davidmctavish/G6_FPGA_Billiards/src/Hardware/project_1/project_1.runs/impl_1/.init_design.begin.rst

<?xml version="1.0"?>
<ProcessHandle Version="1" Minor="0">
    <Process Command=".planAhead." Owner="David" Host="LATITUDE-E5530" Pid="6472">
    </Process>
</ProcessHandle>
