davidmctavish/G6_FPGA_Billiards/src/Hardware/project_1/project_1.runs/impl_1/.vivado.begin.rst

<?xml version="1.0"?>
<ProcessHandle Version="1" Minor="0">
    <Process Command="vivado.bat" Owner="David" Host="LATITUDE-E5530" Pid="6776">
    </Process>
</ProcessHandle>
<?xml version="1.0"?>
<ProcessHandle Version="1" Minor="0">
    <Process Command="vivado.bat" Owner="David" Host="LATITUDE-E5530" Pid="6036">
    </Process>
</ProcessHandle>
