davidmctavish/G6_FPGA_Billiards/src/Hardware/PositionLocatorTest_2014_1/vivado_pid5332.png

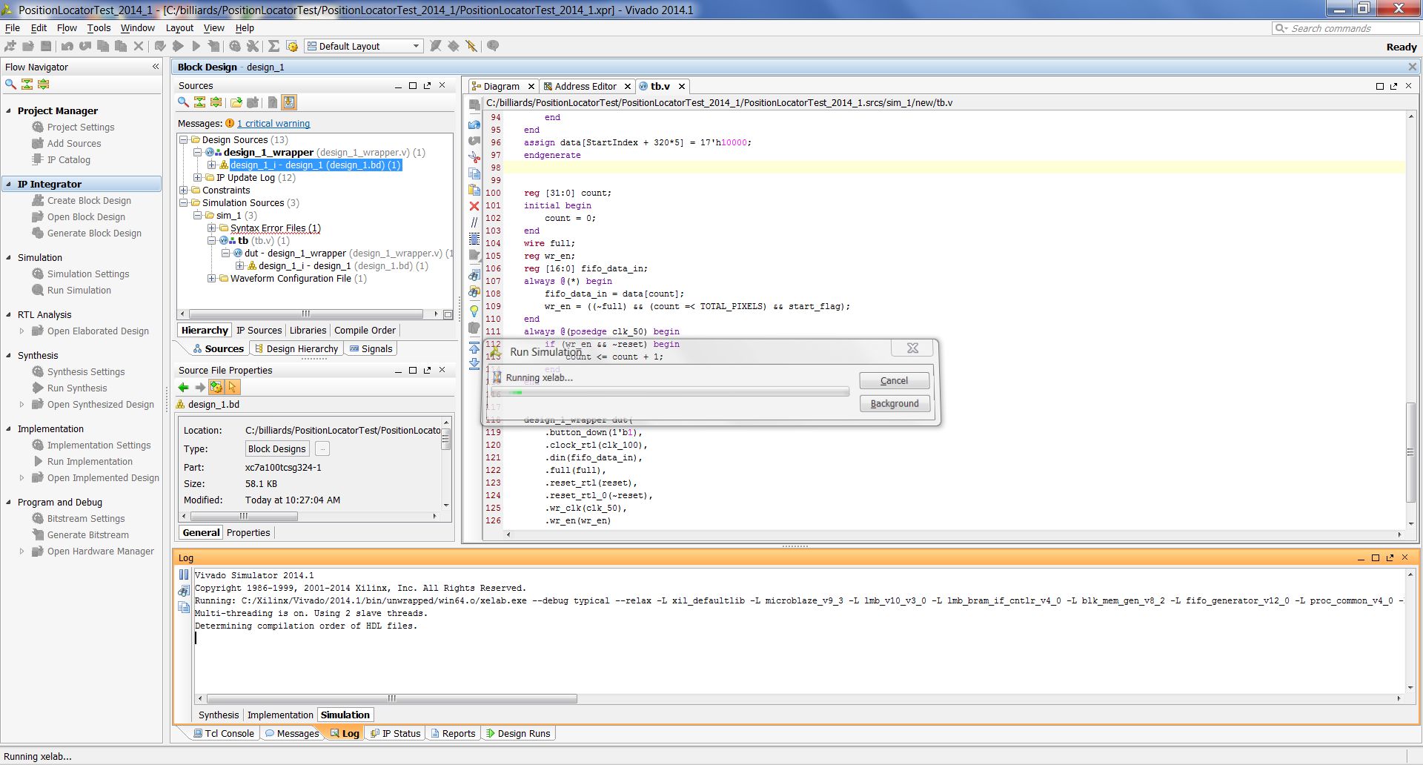
src/Hardware/PositionLocatorTest_2014_1/vivado_pid5332.png
