davidmctavish/G6_FPGA_Billiards/src/Hardware/VivadoIP/ip_repo/poisition_locator_1.0/src/div_gen_0/doc/div_gen_v5_1_changelog.txt

2014.1:
 * Version 5.1 (Rev. 2)
 * C models for Windows are compiled using Microsoft Visual Studio 2012
 * Internal device family name change, no functional changes
 * Netlists created by write_verilog and write_vhdl are IEEE P1735 encrypted, with keys for supported simulators so that netlist simulation can still be done
 * Enable third party synthesis tools to read encrypted netlists (but not source HDL)
 * Support for Virtex Ultrascale devices at Pre-Production Status
 * VCS version H-2013.06-sp1 may cause errors or mismatches between behavioral sim and post- netlists. VCS version I-2014.03-Beta1 or later is recommended.

2013.4:
 * Version 5.1 (Rev. 1)
 * Clock constraint removed from supplied out of context xdc file for cases with no registers
 * ACLKEN and ARESETN disabled ans set to false on GUI when Latency is set to 0
 * Support for Kintex Ultrascale devices at Pre-Production Status

2013.3:
 * Version 5.1
 * Addition of LUT-Mult architecture
 * Addition of configurable latency to Radix 2 architecture
 * Addition of C model
 * Internal standardization in source file delivery, does not change behavior
 * Support for Automotive Artix-7, Automotive Zynq, Defense Grade Artix-7, Defense Grade Zynq and Lower Power Artix-7 devices at Production Status
 * Added support for Cadence IES and Synopsys VCS simulators
 * Added default constraints for out of context flow
 * Added support for IP Integrator
 * Removed C model dependency on stlport (STL Portability) library; C model now uses STL built into the compiler
 * Windows C model DLLs are statically linked to the Windows C run-time (CRT) library, to remove the runtime dependency on MSVCRT90.dll, which can cause problems when using the C model in a Windows compiler other than Visual Studio 2008
 * C model updated to use third-party library MPIR version 2.6.0 (previously was version 2.2.1); the Windows MPIR DLLs are also statically linked to the Windows CRT library, to remove the dependency on MSVCRT90.dll

2013.2:
 * Version 5.0 (Rev. 1)
 * Support for Series 7 devices at Production status
 * Beta support for future devices
 * Removing support for Defense Grade Low Power Artix7

2013.1:
 * Version 5.0
 * Native Vivado Release
 * There have been no functional or interface changes to this IP.  The version number has changed to support unique versioning in Vivado starting with 2013.1.

(c) Copyright 2002 - 2014 Xilinx, Inc. All rights reserved.

This file contains confidential and proprietary information
of Xilinx, Inc. and is protected under U.S. and
international copyright and other intellectual property
laws.

DISCLAIMER
This disclaimer is not a license and does not grant any
rights to the materials distributed herewith. Except as
otherwise provided in a valid license issued to you by
Xilinx, and to the maximum extent permitted by applicable
law: (1) THESE MATERIALS ARE MADE AVAILABLE "AS IS" AND
WITH ALL FAULTS, AND XILINX HEREBY DISCLAIMS ALL WARRANTIES
AND CONDITIONS, EXPRESS, IMPLIED, OR STATUTORY, INCLUDING
BUT NOT LIMITED TO WARRANTIES OF MERCHANTABILITY, NON-
INFRINGEMENT, OR FITNESS FOR ANY PARTICULAR PURPOSE; and
(2) Xilinx shall not be liable (whether in contract or tort,
including negligence, or under any other theory of
liability) for any loss or damage of any kind or nature
related to, arising under or in connection with these
materials, including for any direct, or any indirect,
special, incidental, or consequential loss or damage
(including loss of data, profits, goodwill, or any type of
loss or damage suffered as a result of any action brought
by a third party) even if such damage or loss was
reasonably foreseeable or Xilinx had been advised of the
possibility of the same.

CRITICAL APPLICATIONS
Xilinx products are not designed or intended to be fail-
safe, or for use in any application requiring fail-safe
performance, such as life-support or safety devices or
systems, Class III medical devices, nuclear facilities,
applications related to the deployment of airbags, or any
other applications that could lead to death, personal
injury, or severe property or environmental damage
(individually and collectively, "Critical
Applications"). Customer assumes the sole risk and
liability of any use of Xilinx products in Critical
Applications, subject only to applicable laws and
regulations governing limitations on product liability.

THIS COPYRIGHT NOTICE AND DISCLAIMER MUST BE RETAINED AS
PART OF THIS FILE AT ALL TIMES.
