davidmctavish/G6_FPGA_Billiards/src/Hardware/project_1/project_1.runs/synth_1/.Xil/design_1_wrapper_propImpl.xdc

set_property SRC_FILE_INFO {cfile:c:/billiards/project_1/project_1.srcs/sources_1/bd/design_1/ip/design_1_clk_wiz_1_0/design_1_clk_wiz_1_0.xdc rfile:../../../project_1.srcs/sources_1/bd/design_1/ip/design_1_clk_wiz_1_0/design_1_clk_wiz_1_0.xdc id:1 order:EARLY scoped_inst:design_1_i/clk_wiz_1/inst} [current_design]
set_property SRC_FILE_INFO {cfile:c:/billiards/project_1/project_1.srcs/sources_1/bd/design_1/ip/design_1_mig_7series_0_0/design_1_mig_7series_0_0/user_design/constraints/design_1_mig_7series_0_0.xdc rfile:../../../project_1.srcs/sources_1/bd/design_1/ip/design_1_mig_7series_0_0/design_1_mig_7series_0_0/user_design/constraints/design_1_mig_7series_0_0.xdc id:2 order:EARLY scoped_inst:design_1_i/mig_7series_0} [current_design]
set_property SRC_FILE_INFO {cfile:c:/billiards/project_1/project_1.srcs/sources_1/bd/design_1/ip/design_1_axi_tft_0_0/design_1_axi_tft_0_0_clocks.xdc rfile:../../../project_1.srcs/sources_1/bd/design_1/ip/design_1_axi_tft_0_0/design_1_axi_tft_0_0_clocks.xdc id:3 order:LATE scoped_inst:design_1_i/axi_tft_0/U0} [current_design]
set_property SRC_FILE_INFO {cfile:c:/billiards/project_1/project_1.srcs/sources_1/bd/design_1/ip/design_1_fifo_generator_0_0/design_1_fifo_generator_0_0/design_1_fifo_generator_0_0_clocks.xdc rfile:../../../project_1.srcs/sources_1/bd/design_1/ip/design_1_fifo_generator_0_0/design_1_fifo_generator_0_0/design_1_fifo_generator_0_0_clocks.xdc id:4 order:LATE scoped_inst:design_1_i/fifo_generator_0/U0} [current_design]
set_property SRC_FILE_INFO {cfile:c:/billiards/project_1/project_1.srcs/sources_1/bd/design_1/ip/design_1_auto_cc_0/design_1_auto_cc_0_clocks.xdc rfile:../../../project_1.srcs/sources_1/bd/design_1/ip/design_1_auto_cc_0/design_1_auto_cc_0_clocks.xdc id:5 order:LATE scoped_inst:design_1_i/axi_mem_intercon/m00_couplers/auto_cc/inst} [current_design]
set_property src_info {type:SCOPED_XDC file:1 line:56 export:INPUT save:INPUT read:READ} [current_design]
set_input_jitter [get_clocks -of_objects [get_ports clk_in1]] 0.1
set_property src_info {type:SCOPED_XDC file:2 line:285 export:INPUT save:INPUT read:READ} [current_design]
set_property LOC PHASER_OUT_PHY_X1Y7 [get_cells  -hier -filter {NAME =~ */ddr_phy_4lanes_0.u_ddr_phy_4lanes/ddr_byte_lane_D.ddr_byte_lane_D/phaser_out}]
set_property src_info {type:SCOPED_XDC file:2 line:286 export:INPUT save:INPUT read:READ} [current_design]
set_property LOC PHASER_OUT_PHY_X1Y5 [get_cells  -hier -filter {NAME =~ */ddr_phy_4lanes_0.u_ddr_phy_4lanes/ddr_byte_lane_B.ddr_byte_lane_B/phaser_out}]
set_property src_info {type:SCOPED_XDC file:2 line:287 export:INPUT save:INPUT read:READ} [current_design]
set_property LOC PHASER_OUT_PHY_X1Y6 [get_cells  -hier -filter {NAME =~ */ddr_phy_4lanes_0.u_ddr_phy_4lanes/ddr_byte_lane_C.ddr_byte_lane_C/phaser_out}]
set_property src_info {type:SCOPED_XDC file:2 line:288 export:INPUT save:INPUT read:READ} [current_design]
set_property LOC PHASER_OUT_PHY_X1Y4 [get_cells  -hier -filter {NAME =~ */ddr_phy_4lanes_0.u_ddr_phy_4lanes/ddr_byte_lane_A.ddr_byte_lane_A/phaser_out}]
set_property src_info {type:SCOPED_XDC file:2 line:292 export:INPUT save:INPUT read:READ} [current_design]
set_property LOC PHASER_IN_PHY_X1Y6 [get_cells  -hier -filter {NAME =~ */ddr_phy_4lanes_0.u_ddr_phy_4lanes/ddr_byte_lane_C.ddr_byte_lane_C/phaser_in_gen.phaser_in}]
set_property src_info {type:SCOPED_XDC file:2 line:293 export:INPUT save:INPUT read:READ} [current_design]
set_property LOC PHASER_IN_PHY_X1Y4 [get_cells  -hier -filter {NAME =~ */ddr_phy_4lanes_0.u_ddr_phy_4lanes/ddr_byte_lane_A.ddr_byte_lane_A/phaser_in_gen.phaser_in}]
set_property src_info {type:SCOPED_XDC file:2 line:297 export:INPUT save:INPUT read:READ} [current_design]
set_property LOC OUT_FIFO_X1Y7 [get_cells  -hier -filter {NAME =~ */ddr_phy_4lanes_0.u_ddr_phy_4lanes/ddr_byte_lane_D.ddr_byte_lane_D/out_fifo}]
set_property src_info {type:SCOPED_XDC file:2 line:298 export:INPUT save:INPUT read:READ} [current_design]
set_property LOC OUT_FIFO_X1Y5 [get_cells  -hier -filter {NAME =~ */ddr_phy_4lanes_0.u_ddr_phy_4lanes/ddr_byte_lane_B.ddr_byte_lane_B/out_fifo}]
set_property src_info {type:SCOPED_XDC file:2 line:299 export:INPUT save:INPUT read:READ} [current_design]
set_property LOC OUT_FIFO_X1Y6 [get_cells  -hier -filter {NAME =~ */ddr_phy_4lanes_0.u_ddr_phy_4lanes/ddr_byte_lane_C.ddr_byte_lane_C/out_fifo}]
set_property src_info {type:SCOPED_XDC file:2 line:300 export:INPUT save:INPUT read:READ} [current_design]
set_property LOC OUT_FIFO_X1Y4 [get_cells  -hier -filter {NAME =~ */ddr_phy_4lanes_0.u_ddr_phy_4lanes/ddr_byte_lane_A.ddr_byte_lane_A/out_fifo}]
set_property src_info {type:SCOPED_XDC file:2 line:302 export:INPUT save:INPUT read:READ} [current_design]
set_property LOC IN_FIFO_X1Y6 [get_cells  -hier -filter {NAME =~ */ddr_phy_4lanes_0.u_ddr_phy_4lanes/ddr_byte_lane_C.ddr_byte_lane_C/in_fifo_gen.in_fifo}]
set_property src_info {type:SCOPED_XDC file:2 line:303 export:INPUT save:INPUT read:READ} [current_design]
set_property LOC IN_FIFO_X1Y4 [get_cells  -hier -filter {NAME =~ */ddr_phy_4lanes_0.u_ddr_phy_4lanes/ddr_byte_lane_A.ddr_byte_lane_A/in_fifo_gen.in_fifo}]
set_property src_info {type:SCOPED_XDC file:2 line:305 export:INPUT save:INPUT read:READ} [current_design]
set_property LOC PHY_CONTROL_X1Y1 [get_cells  -hier -filter {NAME =~ */ddr_phy_4lanes_0.u_ddr_phy_4lanes/phy_control_i}]
set_property src_info {type:SCOPED_XDC file:2 line:307 export:INPUT save:INPUT read:READ} [current_design]
set_property LOC PHASER_REF_X1Y1 [get_cells  -hier -filter {NAME =~ */ddr_phy_4lanes_0.u_ddr_phy_4lanes/phaser_ref_i}]
set_property src_info {type:SCOPED_XDC file:2 line:309 export:INPUT save:INPUT read:READ} [current_design]
set_property LOC OLOGIC_X1Y81 [get_cells  -hier -filter {NAME =~ */ddr_phy_4lanes_0.u_ddr_phy_4lanes/ddr_byte_lane_C.ddr_byte_lane_C/ddr_byte_group_io/*slave_ts}]
set_property src_info {type:SCOPED_XDC file:2 line:310 export:INPUT save:INPUT read:READ} [current_design]
set_property LOC OLOGIC_X1Y57 [get_cells  -hier -filter {NAME =~ */ddr_phy_4lanes_0.u_ddr_phy_4lanes/ddr_byte_lane_A.ddr_byte_lane_A/ddr_byte_group_io/*slave_ts}]
set_property src_info {type:SCOPED_XDC file:2 line:312 export:INPUT save:INPUT read:READ} [current_design]
set_property LOC PLLE2_ADV_X1Y1 [get_cells -hier -filter {NAME =~ */u_ddr2_infrastructure/plle2_i}]
set_property src_info {type:SCOPED_XDC file:2 line:313 export:INPUT save:INPUT read:READ} [current_design]
set_property LOC MMCME2_ADV_X1Y1 [get_cells -hier -filter {NAME =~ */u_ddr2_infrastructure/gen_mmcm.mmcm_i}]
set_property src_info {type:SCOPED_XDC file:2 line:337 export:INPUT save:INPUT read:READ} [current_design]
set_max_delay -datapath_only -from [get_cells -hier -filter {NAME =~ *temp_mon_enabled.u_tempmon/*}] -to [get_cells -hier -filter {NAME =~ *temp_mon_enabled.u_tempmon/device_temp_sync_r1*}] 20
set_property src_info {type:SCOPED_XDC file:2 line:338 export:INPUT save:INPUT read:READ} [current_design]
set_max_delay -from [get_cells -hier *rstdiv0_sync_r1_reg*] -to [get_pins -filter {NAME =~ */RESET} -of [get_cells -hier -filter {REF_NAME == PHY_CONTROL}]] -datapath_only 5
set_property src_info {type:SCOPED_XDC file:2 line:342 export:INPUT save:INPUT read:READ} [current_design]
set_max_delay -datapath_only -from [get_cells -hier -filter {NAME =~ *ddr2_infrastructure/rstdiv0_sync_r1_reg*}] -to [get_cells -hier -filter {NAME =~ *temp_mon_enabled.u_tempmon/xadc_supplied_temperature.rst_r1*}] 20
set_property src_info {type:SCOPED_XDC file:3 line:54 export:INPUT save:INPUT read:READ} [current_design]
set_max_delay -from [get_cells -hier -filter NAME=~*inst_fifo_gen/gconvfifo.rf/grf.rf/gntv_or_sync_fifo.gcx.clkx/rd_pntr_gc_reg[*]] -to [get_cells -hier -filter NAME=~*inst_fifo_gen/gconvfifo.rf/grf.rf/gntv_or_sync_fifo.gcx.clkx/gsync_stage[*].wr_stg_inst/Q_reg_reg[*]] -datapath_only [get_property -min PERIOD [get_clocks -of_objects [get_pins design_1_i/axi_tft_0/U0/sys_tft_clk]]]
set_property src_info {type:SCOPED_XDC file:3 line:55 export:INPUT save:INPUT read:READ} [current_design]
set_max_delay -from [get_cells -hier -filter NAME=~*inst_fifo_gen/gconvfifo.rf/grf.rf/gntv_or_sync_fifo.gcx.clkx/wr_pntr_gc_reg[*]] -to [get_cells -hier -filter NAME=~*inst_fifo_gen/gconvfifo.rf/grf.rf/gntv_or_sync_fifo.gcx.clkx/gsync_stage[*].rd_stg_inst/Q_reg_reg[*]] -datapath_only [get_property -min PERIOD [get_clocks -of_objects [get_pins design_1_i/axi_tft_0/U0/m_axi_aclk]]]
set_property src_info {type:SCOPED_XDC file:4 line:61 export:INPUT save:INPUT read:READ} [current_design]
set_max_delay -from [get_cells inst_fifo_gen/gconvfifo.rf/grf.rf/gntv_or_sync_fifo.gcx.clkx/rd_pntr_gc_reg[*]] -to [get_cells inst_fifo_gen/gconvfifo.rf/grf.rf/gntv_or_sync_fifo.gcx.clkx/gsync_stage[*].wr_stg_inst/Q_reg_reg[*]] -datapath_only [get_property -min PERIOD [get_clocks -of_objects [get_pins design_1_i/fifo_generator_0/U0/rd_clk]]]
set_property src_info {type:SCOPED_XDC file:4 line:63 export:INPUT save:INPUT read:READ} [current_design]
set_max_delay -from [get_cells inst_fifo_gen/gconvfifo.rf/grf.rf/gntv_or_sync_fifo.gcx.clkx/wr_pntr_gc_reg[*]] -to [get_cells inst_fifo_gen/gconvfifo.rf/grf.rf/gntv_or_sync_fifo.gcx.clkx/gsync_stage[*].rd_stg_inst/Q_reg_reg[*]] -datapath_only [get_property -min PERIOD [get_clocks -of_objects [get_ports OV7670_PCLK]]]
set_property src_info {type:SCOPED_XDC file:5 line:19 export:INPUT save:INPUT read:READ} [current_design]
set_max_delay -from [filter [all_fanout -from [get_ports s_axi_aclk] -flat -endpoints_only] {IS_LEAF}] -to [filter [all_fanout -from [get_ports m_axi_aclk] -flat -only_cells] {IS_SEQUENTIAL && (NAME !~ *dout_i_reg[*])}] -datapath_only [get_property -min PERIOD [get_clocks -of_objects [get_pins design_1_i/axi_mem_intercon/m00_couplers/auto_cc/inst/s_axi_aclk]]]
set_property src_info {type:SCOPED_XDC file:5 line:20 export:INPUT save:INPUT read:READ} [current_design]
set_max_delay -from [filter [all_fanout -from [get_ports m_axi_aclk] -flat -endpoints_only] {IS_LEAF}] -to [filter [all_fanout -from [get_ports s_axi_aclk] -flat -only_cells] {IS_SEQUENTIAL && (NAME !~ *dout_i_reg[*])}] -datapath_only [get_property -min PERIOD [get_clocks -of_objects [get_pins design_1_i/axi_mem_intercon/m00_couplers/auto_cc/inst/m_axi_aclk]]]
