davidmctavish/G6_FPGA_Billiards/src/Hardware/VivadoIP/ip_repo/poisition_locator_1.0/src/div_gen_0/div_gen_v5_1/hdl/hrdiv/flow_ctrl.vhd

`protect begin_protected
`protect version = 1
`protect encrypt_agent = "XILINX"
`protect encrypt_agent_info = "Xilinx Encryption Tool 2014"
`protect key_keyowner = "Cadence Design Systems.", key_keyname= "cds_rsa_key", key_method = "rsa"
`protect encoding = (enctype = "BASE64", line_length = 76, bytes = 64)
`protect key_block
k9EcE/Ttz4EQSSoj3Tn8UH0DjuncGgofc+M6/9Hhflps2vGciBSX2/boa0OQ97bwTfzz65Ow+9hD
k67FLGUvVg==

`protect key_keyowner = "Mentor Graphics Corporation", key_keyname= "MGC-VERIF-SIM-RSA-1", key_method = "rsa"
`protect encoding = (enctype = "BASE64", line_length = 76, bytes = 128)
`protect key_block
VFeUpCMAKURvRnJd4FtouvGOMUJUYsTW7nV3mvVN1k6VERJGz6cwPFH7fH/ZNM7jjR/6L/Hlcz6T
m3L89s2My4OtTdC1XSdWHoxkTWCL9mNXjQwOyD9rv8rwfYY6iTf4EDdWLKl+Jgt0WjwhSvHlU8PV
eBf/FeQrmcBHZyAFYJk=

`protect key_keyowner = "Xilinx", key_keyname= "xilinx_2014_03", key_method = "rsa"
`protect encoding = (enctype = "BASE64", line_length = 76, bytes = 256)
`protect key_block
PhPaJ4+ekxtGBZu67J2W88TsVlsWXwcF+bqkLin0/c7PBzss/msNSgkmx/PGCOT2puL/nE2At0yK
o335DtPzR7v1MPJpFpV5+Ue5xV0wf38vnCR/I/pgnfqZ0L1liYokI442QqXzQX+56zT1R8tkXW7Q
bsx33hcQzMElulMCcSRrje+G4kO0kE+vaS001FRxtB39XZdg56VDy3C8K1QPas7ud658plnx3B3z
nVKCyjKKYdgrTQjFBnZWlw8WnuvoBY4gfjFCzGhdFtv9jolMOiRvbCF7iUKfm2Xa9icf71pgIuVX
cEBmF6S5IS6nkJ2SchqgcSptfJOf/mfkzYOWKA==

`protect key_keyowner = "Synopsys", key_keyname= "SNPS-VCS-RSA-1", key_method = "rsa"
`protect encoding = (enctype = "BASE64", line_length = 76, bytes = 128)
`protect key_block
Cv/TIczjBqHIaCX9aqpdmwJf34C77wKq1IkBT/ED2zCSYURZ/SfSFXpTliI190UNQm3r5ACXa7fv
eiU6MafQ0RYZ2k+IHqV0/yMsSNXkddi06VQqRalLnPtEJA62C+gqdm7wrBwbFHC+wux2ft+tvUZM
q14O3QOaCrVCENCclwo=

`protect key_keyowner = "Aldec", key_keyname= "ALDEC08_001", key_method = "rsa"
`protect encoding = (enctype = "BASE64", line_length = 76, bytes = 256)
`protect key_block
B3TjeHK9bY2EiIEPZE2NccEBbBYKDmz3eWhlVOLLlswKOiMd5wlkJdgLOqtCq+GYzomVI5uKxunC
0HhkiUKbXK9RjGkUyrE6xk111b7uJ2phCyxtVePh1JAuJreK9RT0UmOxL6qI6lwZPv3kLTC+hbCk
j5pFizEw4F2sdes/MxFuO15+kkhfTMlWMALw2K8SBLP1kWA/JBZOqtTkDOB3wCxoy0Nom34b3aX3
0YaYsK8afg+s6QE2zHQcD8z/xX7wBFI1zima2XvMO0g+CdGL/i3JXmf1ak6WsQqJSPmo+AT4JmX5
/1lHKYt4K5yN1Cf7LxJS28VktftlZOf4GEZamQ==

`protect data_method = "AES128-CBC"
`protect encoding = (enctype = "BASE64", line_length = 76, bytes = 5232)
`protect data_block
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
`protect end_protected
