davidmctavish/G6_FPGA_Billiards/src/Hardware/project_1/project_1.srcs/sources_1/ipshared/xilinx.com/microblaze_v9_3/7b6e2d75/hdl/vhdl/data_read_steering.vhd

`protect begin_protected
`protect version = 1
`protect encrypt_agent = "XILINX"
`protect encrypt_agent_info = "Xilinx Encryption Tool 2014"
`protect key_keyowner = "Cadence Design Systems.", key_keyname= "cds_rsa_key", key_method = "rsa"
`protect encoding = (enctype = "BASE64", line_length = 76, bytes = 64)
`protect key_block
O1Ea1lFQUhaHmF97sdcfjBfBJtH7aRlzoc3JDqDFfLIvb97rWqGVYpYwtz4fxw5OehVZo2zeun6m
TgMOE6Tg6Q==

`protect key_keyowner = "Mentor Graphics Corporation", key_keyname= "MGC-VERIF-SIM-RSA-1", key_method = "rsa"
`protect encoding = (enctype = "BASE64", line_length = 76, bytes = 128)
`protect key_block
Mb8VP49Sj0A0QmlThMZdbd9F6x8Xeusr/dclQGVQHmWmnKtxa3eHJgeVSDD7hs/7lW4P01aebv4E
O+LgXxBNmcSNx7oyo5Fbm0kyKVE7pMlEQr6rN+JGpNMeTfTFRJ0273JM6NanNo2jT5I9FCH795g+
8TZ3uVGizyZgN07VxeA=

`protect key_keyowner = "Xilinx", key_keyname= "xilinx_2014_03", key_method = "rsa"
`protect encoding = (enctype = "BASE64", line_length = 76, bytes = 256)
`protect key_block
LNmxpLHPJv3D8s1Y6T8xzpQ9mAgJrssBOSGPXaSCPuEXLLgKCI0S1ugeILreIrjQQzpqz9RMIIBS
HECPdpkk9Kx7n6eeoUSnHlENhmv4uibdgC9O5EaKsHhD0a428cxWEyDk8dviuNK/sthF0gRznSW0
vTdYvboUNVHPHYOquNUKVccKxlPOSaIm8RnmvMiqKzAGTvXKLGNTCkVWIl52zt/bpKtRdFB1g0wG
lLDlRe8fp0tF4PCqmzG8NKm7Wc8ozc0wIX1t9bBGrS763YwnstaogpuAjd2Zk+r81MgJ3NRFmoWm
iPDYmFTSJcaKSY0M+nOs/9vwcfODF0q6AMWB0w==

`protect key_keyowner = "Synopsys", key_keyname= "SNPS-VCS-RSA-1", key_method = "rsa"
`protect encoding = (enctype = "BASE64", line_length = 76, bytes = 128)
`protect key_block
bpayqd32nQFYWCP/XrJPR4zjrFnNzUeM9UqUZ+J+NmKrfrpXfAGYnQXCNMoS0fFm6Y192h27/jSw
wyJrL5NmEKgOsPg1vQrAhqBusIiAba+aAJDKh2JwsA8XI9Fh+Oud3Rbov7chCZdDL2XqntO7VxeC
MAVLz8q5rJ9WcdNSBk8=

`protect key_keyowner = "Aldec", key_keyname= "ALDEC08_001", key_method = "rsa"
`protect encoding = (enctype = "BASE64", line_length = 76, bytes = 256)
`protect key_block
BdT8YC2Az+FvF6kQemyu4Dh7dEoGr8oqAp+TkPOp1kQjX0sgmacdUvBuCJ2FO9CAYaSArAJigTIh
94qCf1ZVq6nSOiUAeJP6uY2fuqcbEeDQIMdzL+X2cSS/p26832We2btxDf2WFH/LrWiAlDioZ51q
G3yukGliByZnQy9zjD0m5w4rVApCj+sLCW/AOn2XtmcBhAE/NlFN7cD4QeChTGZ1MYkyzig7oeEb
9pkNIe+RlooLSrV3zFQvIOWoZSzA8bWfqcVmKN3c2CDXHNLo9kFuj2y8PSuYLKTXNvTFIv/KDbAa
1oVZ+k0IgJuw4UsdtAsjkaAOTPGq8/GO3HzlPg==

`protect data_method = "AES128-CBC"
`protect encoding = (enctype = "BASE64", line_length = 76, bytes = 8496)
`protect data_block
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
0lvy
`protect end_protected
