davidmctavish/G6_FPGA_Billiards/src/Hardware/VivadoIP/ip_repo/poisition_locator_1.0/src/div_gen_0/floating_point_v7_0/hdl/flt_add/flt_add.vhd

`protect begin_protected
`protect version = 1
`protect encrypt_agent = "XILINX"
`protect encrypt_agent_info = "Xilinx Encryption Tool 2014"
`protect key_keyowner = "Cadence Design Systems.", key_keyname= "cds_rsa_key", key_method = "rsa"
`protect encoding = (enctype = "BASE64", line_length = 76, bytes = 64)
`protect key_block
UwidsHm9kZtvqpprCOxNi4Wj7QY6kHUV5u2S/05k1IfVTDCXOXoPfcSdib04EWFjSgtbZvYvgtMy
AF07jFvr9A==

`protect key_keyowner = "Mentor Graphics Corporation", key_keyname= "MGC-VERIF-SIM-RSA-1", key_method = "rsa"
`protect encoding = (enctype = "BASE64", line_length = 76, bytes = 128)
`protect key_block
AwHrnmlG4h7xB9MFOxFvEMEAUpHOrMgvUM7cJ5oh1Hjo2WM0aCJTk51hRjCbnHcSyj74Vl2dGp5y
O5ZdRSXs8Q4pFB6t0mX1x9yoycznN9yHWXfVgmn0GKpJMf6TL4JAnnshyysHg/shvujDPs/K6qyw
PCba5FGfp8WVKtD66LA=

`protect key_keyowner = "Xilinx", key_keyname= "xilinx_2014_03", key_method = "rsa"
`protect encoding = (enctype = "BASE64", line_length = 76, bytes = 256)
`protect key_block
aWNXcSmM/kXT4Ootou/K+oWzrTeeGE6+LgFeC9th9GbUHC2mE/uws3wZdJDgAbrudl5wSJG1AKSr
Vq2Fe2jR4YW9JODZLrWrn4HtLTKMAI2b0E54MQTq4zq5t34qrUvRII2t5SQTg4+8hhwpX7euIC87
ESJzbxlSgzKlNp3xVJdtOj85bsEGYXoNUQLbi3QzictypyEHFO1KmuEyx6sD8VayR8llg/AYXNOJ
0z7RMt5U5K+4uP5WdhPH1V5l+F2hUrmgY/FGAaLXB5y+rlDV0JTA1LyYJBHjZhy1WXLm8bmB8mOG
6Wd8Nf7myac0I2egs7tJpR4T48l1OSQytsv3Tw==

`protect key_keyowner = "Synopsys", key_keyname= "SNPS-VCS-RSA-1", key_method = "rsa"
`protect encoding = (enctype = "BASE64", line_length = 76, bytes = 128)
`protect key_block
f9942sDS/pf7hm5KsE+Xv09jiwMnU8rpFyBFahd4aYAeVA9//xlBoReE8lVAWjPsWmMxRSzsDL6X
KmLWwbZLr0tInCOUZPj9rp0GdLf8IBFtf6O7z+7M2JLCI98qeZQzaTBAajZiG7HvOdE8wutApQ7+
r4vO1+JGqGWhlPzpTbE=

`protect key_keyowner = "Aldec", key_keyname= "ALDEC08_001", key_method = "rsa"
`protect encoding = (enctype = "BASE64", line_length = 76, bytes = 256)
`protect key_block
sgldOVjedMNc1EokIehfeha1DzqmuvzBsdlfYSGvOpsyW9mjRJJV465LPK4Y1lRnECrRiYJoc2NG
GWKF/093lyyMB8J3suejmDD38vYtEg2WwHxgW9gd4jy3f3O8SD73/T7qJslRLOWsAK5STwqbFjG9
XfIPdsDaf7hYhf1QgJ6qvidzK+bmOTgxZGM+TyfG5j7WvcBeyw2IwJSA8RShuCJQ9aMKYtmRbAzC
FT5zrVKSwCVjKAFeK8mrcIgHRPtoPDXo/tNPQ2IAbGe8yIj/shI9S+lxaTlJvWBUQUJTkYEIH0Ma
rQ7FJkb9V07I2mhEcC6h2VlGvhYGvmSzX/vIcw==

`protect data_method = "AES128-CBC"
`protect encoding = (enctype = "BASE64", line_length = 76, bytes = 14832)
`protect data_block
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
XEyY4TQ5O1dct0+Q
`protect end_protected
