davidmctavish/G6_FPGA_Billiards/src/Hardware/VivadoIP/ip_repo/poisition_locator_1.0/src/div_gen_0/floating_point_v7_0/hdl/flt_div/flt_div.vhd

`protect begin_protected
`protect version = 1
`protect encrypt_agent = "XILINX"
`protect encrypt_agent_info = "Xilinx Encryption Tool 2014"
`protect key_keyowner = "Cadence Design Systems.", key_keyname= "cds_rsa_key", key_method = "rsa"
`protect encoding = (enctype = "BASE64", line_length = 76, bytes = 64)
`protect key_block
Oxb42xZJAN7hgYiwGUP0IaaLI0mAC7lChU4YDRTX0OrzHSa3roPff5huu9Cfla98RQibgZJiDWWq
z3pPNBPfZg==

`protect key_keyowner = "Mentor Graphics Corporation", key_keyname= "MGC-VERIF-SIM-RSA-1", key_method = "rsa"
`protect encoding = (enctype = "BASE64", line_length = 76, bytes = 128)
`protect key_block
GY0CG2AOHHdceF8vPjgIQ8/6zd22AKuUT36SLqw1nIxE47SOgzFeqFYp3EcqSOqxskal5uRZSQQP
FzyJhhZUp6MVzHUxiC0ERD3cQB8or3yITbpS3EfrtjTOLrLmYMZQaQDEMipavod07DeTtW1Eoab3
SYcnCu+oQsrVLLS9Ljw=

`protect key_keyowner = "Xilinx", key_keyname= "xilinx_2014_03", key_method = "rsa"
`protect encoding = (enctype = "BASE64", line_length = 76, bytes = 256)
`protect key_block
PuYNgv9lv9s/UaGZDLAfQH9mAWNkymkIV4CSyvgjiNst+dKbi3p7wse0BjfZfk8C/0Vk4lJE+tFd
vXE4kjBn8q/TC8vBM4mnucCNWfWgqjX98oMHGEL1lYPez0tDR6CFxF0WMXpshlc9iSSmIm0kdlmf
6QK6f4Y7eiUumK7iUD5XfFHXqSvxWfehzrt6IBlPyYsk1nEckBGjTqHEaECKrMnAoawfgBfiT5H1
rs+sf0CVKW+0PoT2gCjQt+4x8pZBShC9f/u3KdGBn+S37byH0z08ccguJ7waWBws3WB34u31eeVE
WWL+0WTObuGsjhMznpMM0ofwL9LnBgL7kAp1Qg==

`protect key_keyowner = "Synopsys", key_keyname= "SNPS-VCS-RSA-1", key_method = "rsa"
`protect encoding = (enctype = "BASE64", line_length = 76, bytes = 128)
`protect key_block
3Su7X4kUzt+750BJFTZsyPmjkyMBCylGDXrJDGpj39Zn8XsokAgwhzyU0uCqY9OssDc+dZHnZpKF
NDMBnnpVkIMLTFL8lwxsiLfH7uKblyhSY9cPMIb0n4s62LNW+5NM5wg4gjO73Udd0D2sES07Ya0T
f/hl62tv/+TrGlKX9fw=

`protect key_keyowner = "Aldec", key_keyname= "ALDEC08_001", key_method = "rsa"
`protect encoding = (enctype = "BASE64", line_length = 76, bytes = 256)
`protect key_block
M9VTKfU5hWA+a2tCk3bwE0UBo7QTmPR93uMNSBKu940AUFEMMJJT1eiMaT5SN1S7tzXt8H0fQH/5
2/0BJDHJaAQa9HXquqW9Iqc+XZSrtll4gO6u+AXnFFO751/D16ctdG/3IzksWMSRQbAeJ5rPyEHa
nsSd+UaBqzDuhC4relFlsD2wCeOG+GvrfSMAPDyH0ygGb+etEa4/ioGrFJGuB/F0K1Ch+BmyBtHo
C0xKZ21ymX1hPQGBc7jStvZFXbEdLimWPRrvZD6G6QuS1qe/zBDPeu2XDCVvIkxMs5mXbdKkNEkL
3xfK+FEiLCgwbrCesSxDBQBwdkD3FOwrFhtqVw==

`protect data_method = "AES128-CBC"
`protect encoding = (enctype = "BASE64", line_length = 76, bytes = 15264)
`protect data_block
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
`protect end_protected
