davidmctavish/G6_FPGA_Billiards/(notices)

Notices in the files:
src/Hardware/project_1/project_1.srcs/sources_1/ipshared/xilinx.com/axi_tft_v2_0/05601f17/hdl/src/verilog/axi_tft_v2_0_tft_controller.v:
-- (c) Copyright 1984 - 2012 Xilinx, Inc. All rights reserved. --
